ai-poet/cyber-spirit-robot-base/电池电路原理图.pdf

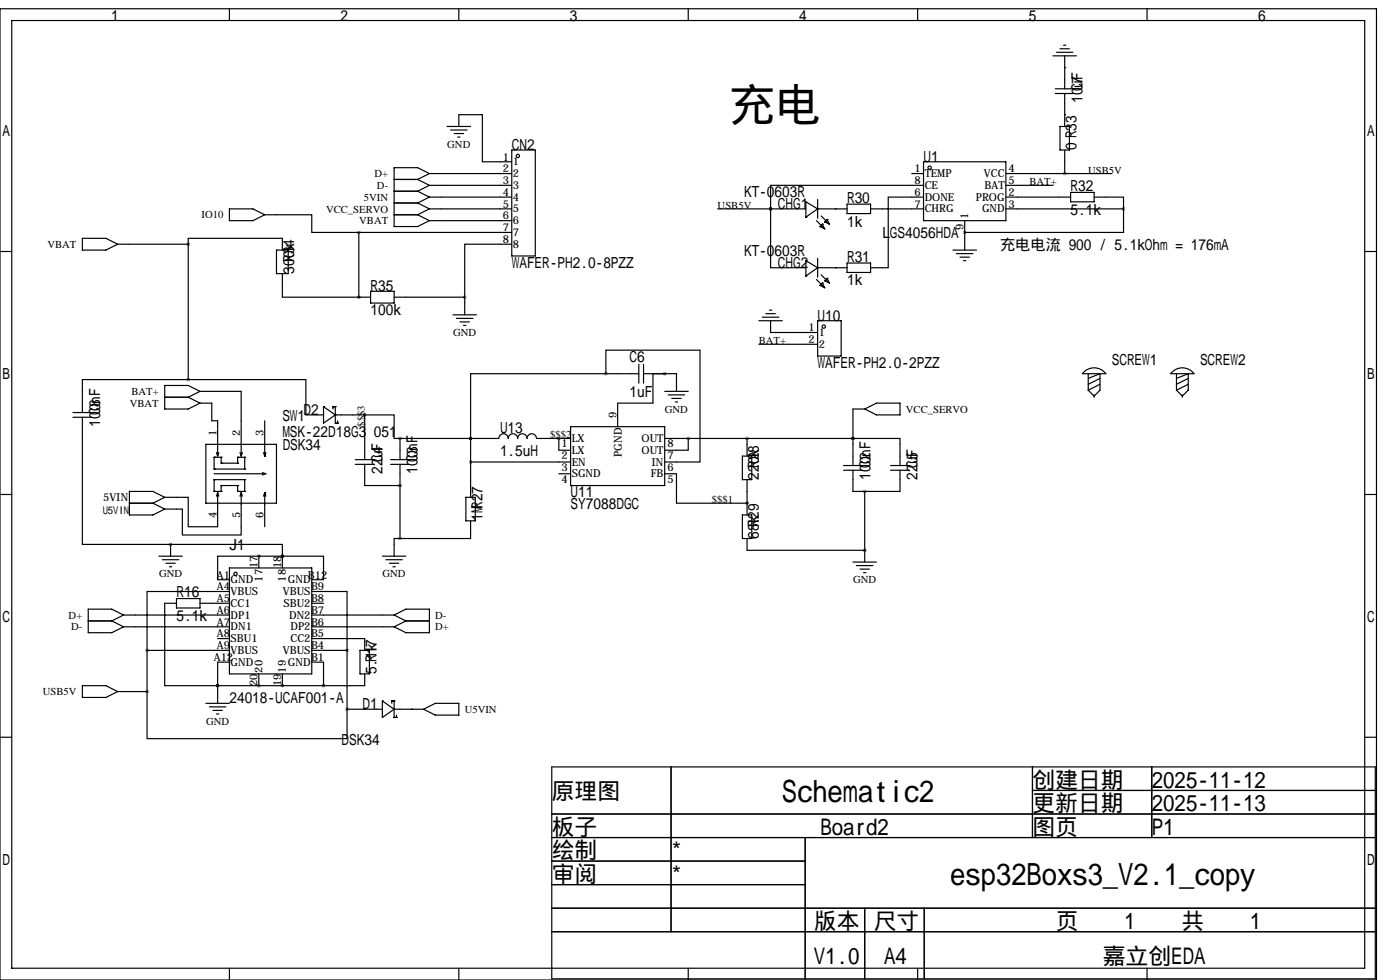
[picture p10: page 1]

Schematic2 | 创建日期 | 2025-11-12 原理图

更新日期 | 2025-11-13

板子 | Board2 | 图页 | P1
绘制 | | esp32Boxs3_V2.1_copy
审阅

V1.0 | A4 | 嘉立创EDA
