ai-poet/cyber-spirit-robot-base/舵机驱动电路原理图.pdf

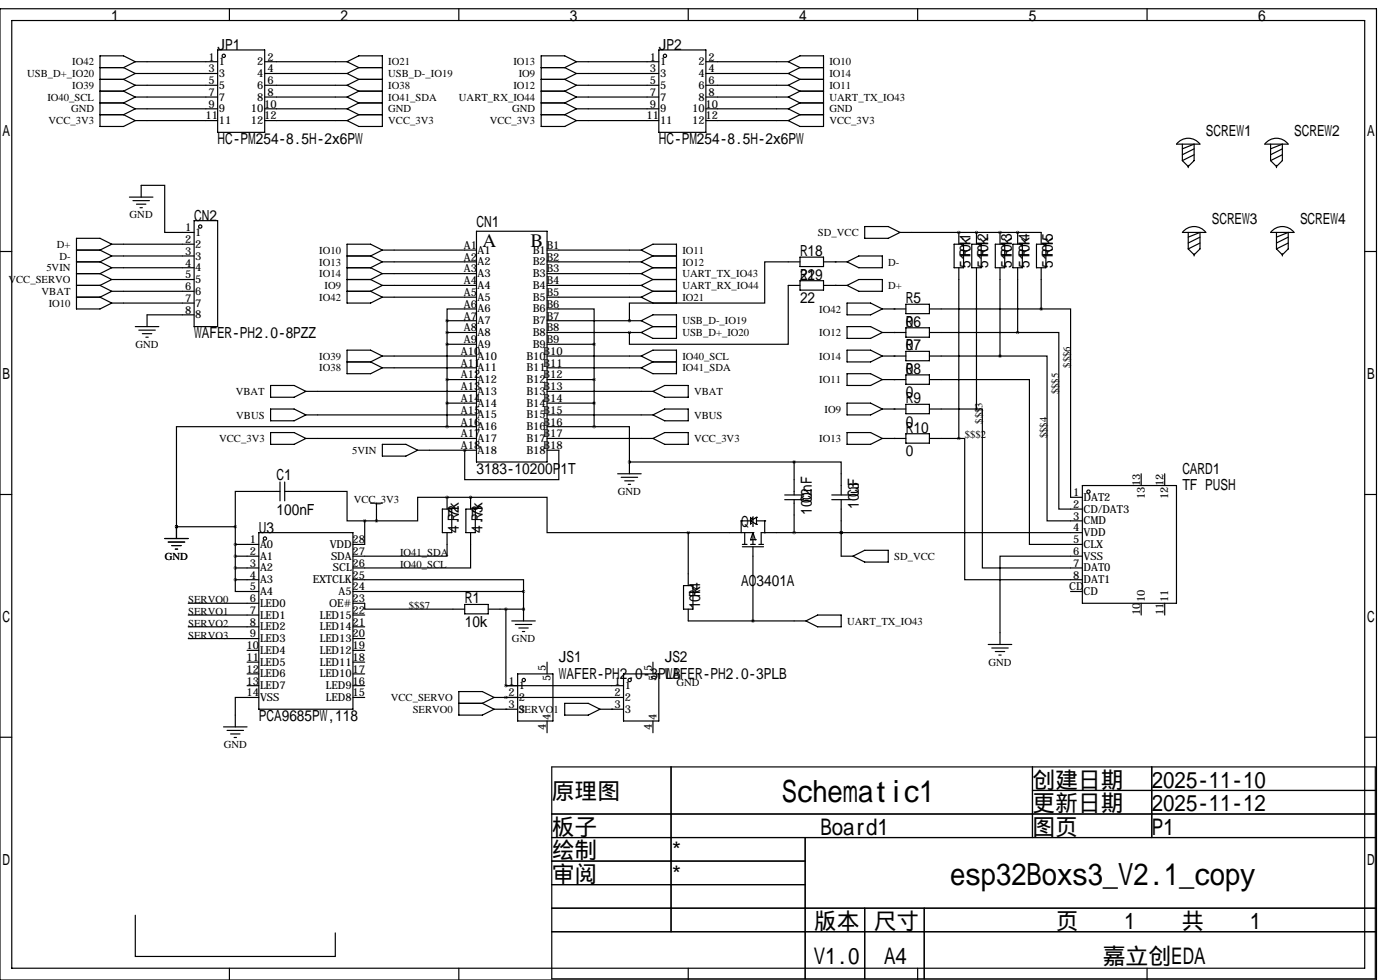
[picture p11: page 1]

Schematic1 | 创建日期 | 2025-11-10 原理图

更新日期 | 2025-11-12

板子 | Board1 | 图页 | P1
绘制 | | esp32Boxs3_V2.1_copy
审阅

V1.0 | A4 | 嘉立创EDA
