ai-poet/cyber-spirit-robot-base/(list of files, drawings)

Other design files:
pcb工程文件.epro
