ai-poet/cyber-spirit-robot-base/(commit log)

2026-01-30 Initial commit: Cyber Spirit 机器人底座硬件设计文件
    - 3D外壳模型 (STEP格式)
    - PCB工程文件 (立创EDA格式)
    - 电池电路原理图 (PDF)
    - 舵机驱动电路原理图 (PDF)
    - 项目文档 (README.md, CLAUDE.md)
    - 产品展示图片
    [pcb工程文件.epro]
2026-01-30 docs: 移除已删除的 promo-video 目录描述
