ai-poet/cyber-spirit-robot-base/(notices)

Notices in the files:
README.md:
License: MIT
